benjlester/OpenHD-CM4-Carrier-Board/README.md

# OpenHD-CM4-Carrier-Board

This project is ongoing. Please see the [Open.HD wiki](https://openhd.gitbook.io/open-hd/) for more information. 

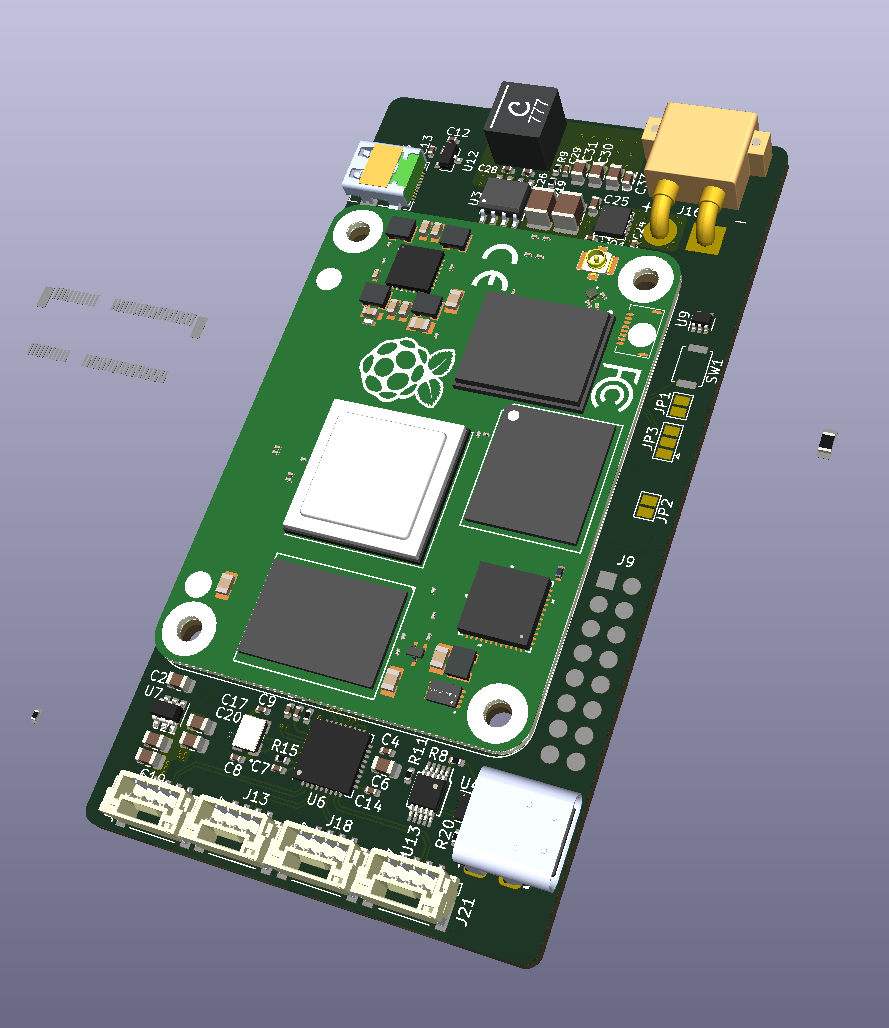
[picture p1: Docs/progress.PNG]
progresspic
