benjlester/OpenHD-CM4-Carrier-Board/Circuits/CM4_Carrier.pdf

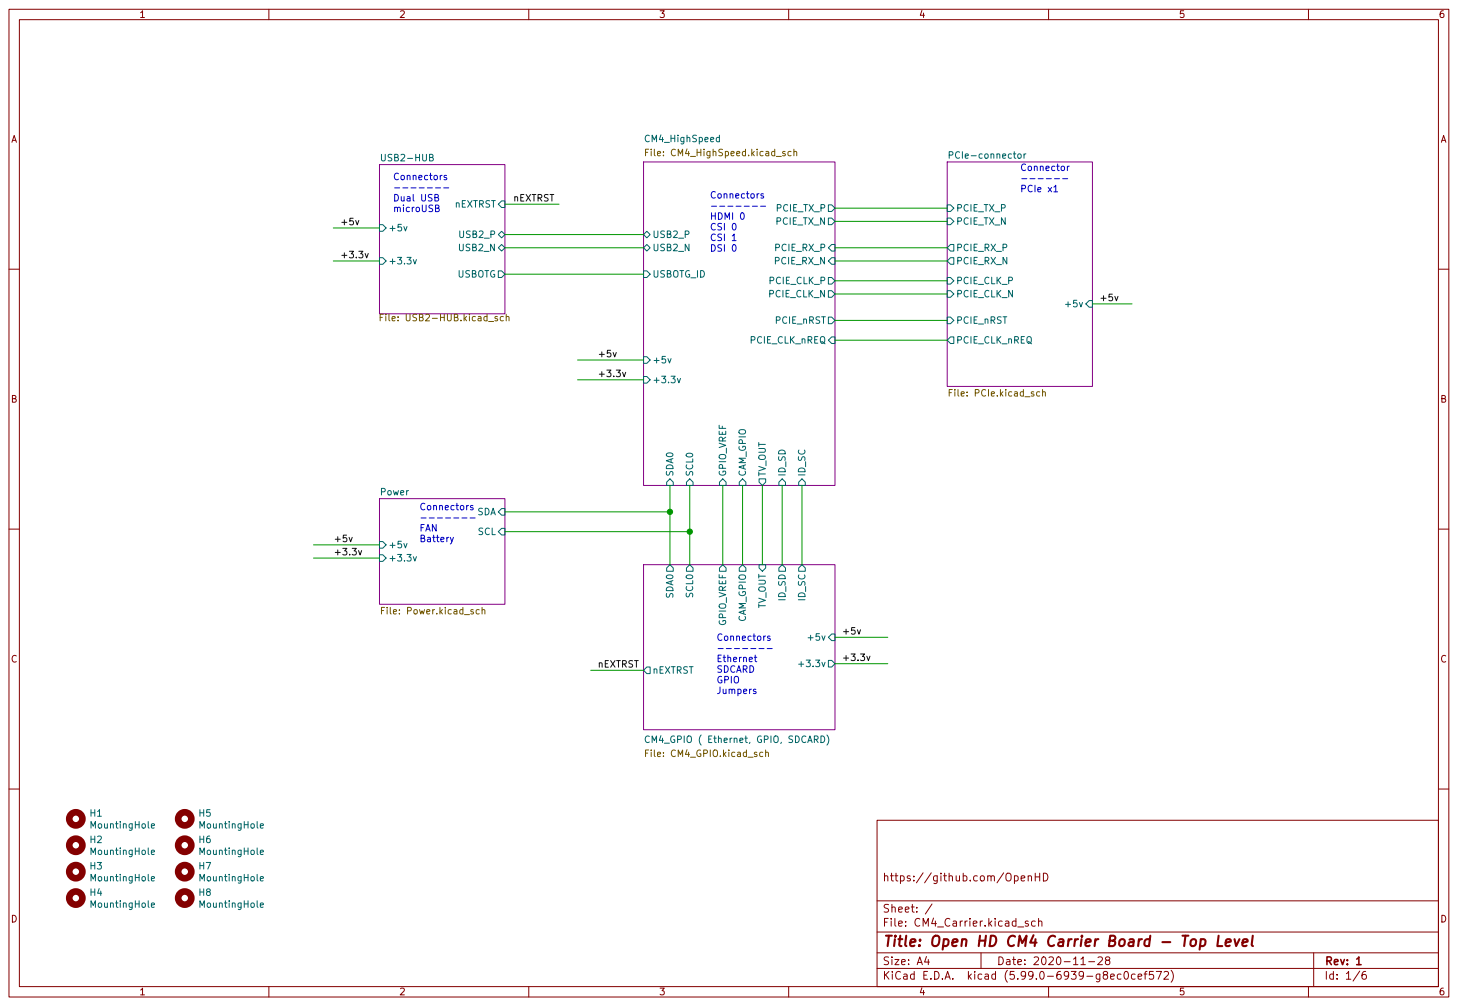
[picture p2: page 1]

------- Dual USB microUSB Connectors

PCIe-connector File: PCIe.kicad_sch PCIE_CLK_P

------ PCIe x1 Connectors
Connectors
------- HDMI 0 CSI 0 CSI 1 DSI 0

File: CM4_Carrier.kicad_sch Sheet: / https://github.com/OpenHD

Id: 1/6 Title: Open HD CM4 Carrier Board - Top Level

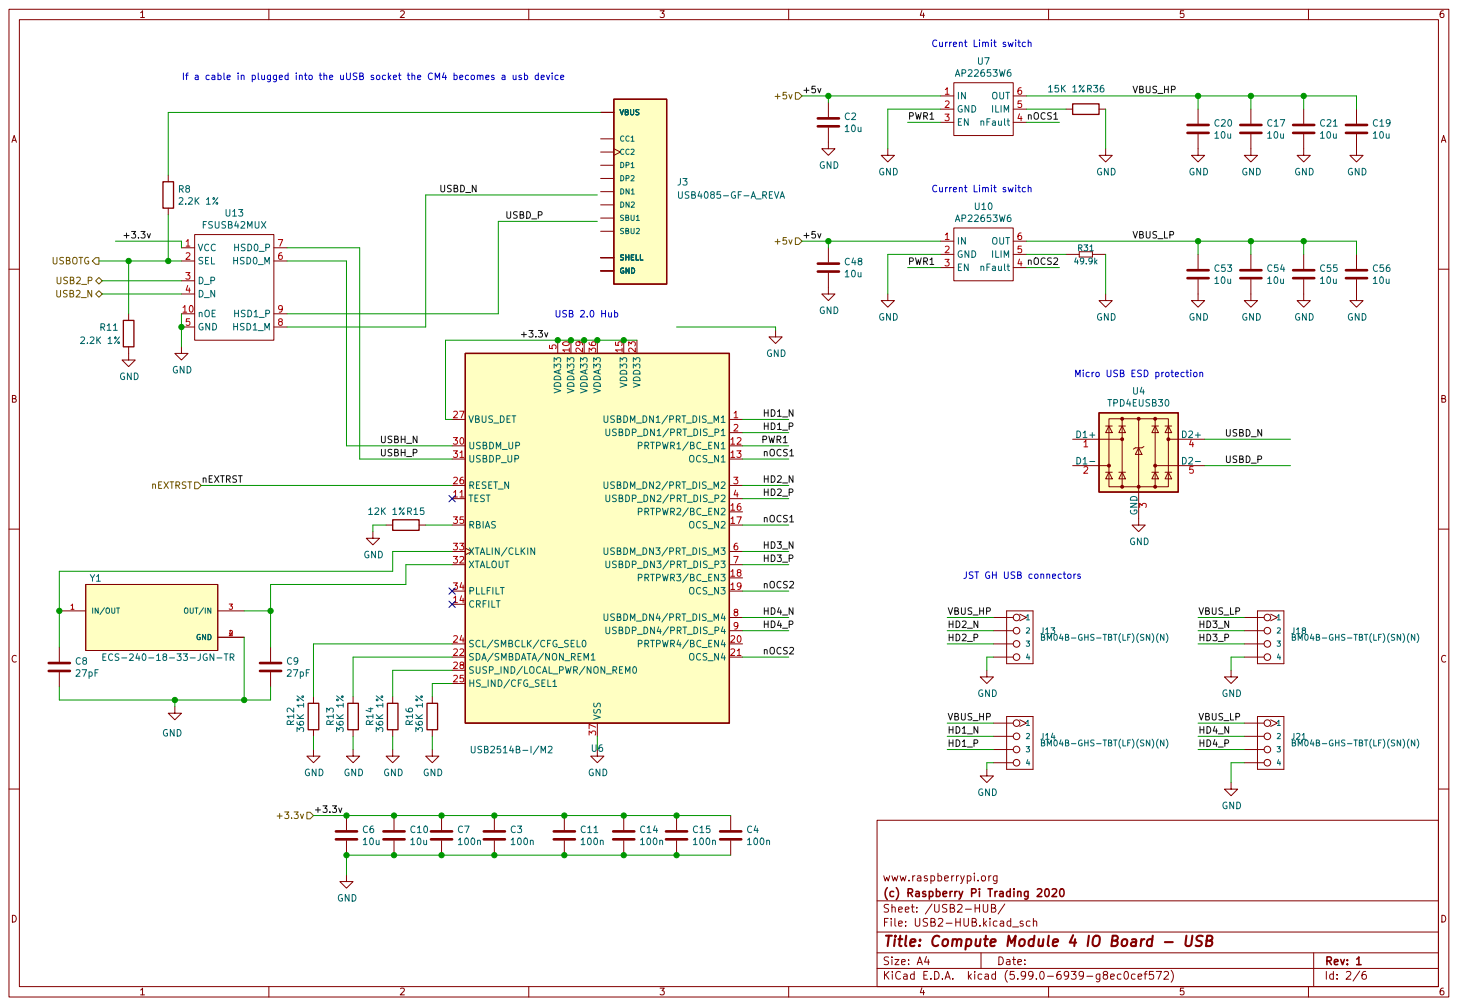
[picture p3: page 2]

JST GH USB connectors

www.raspberrypi.org
File: USB2-HUB.kicad_sch Sheet: /USB2-HUB/ (c) Raspberry Pi Trading 2020

Id: 2/6 Title: Compute Module 4 IO Board - USB

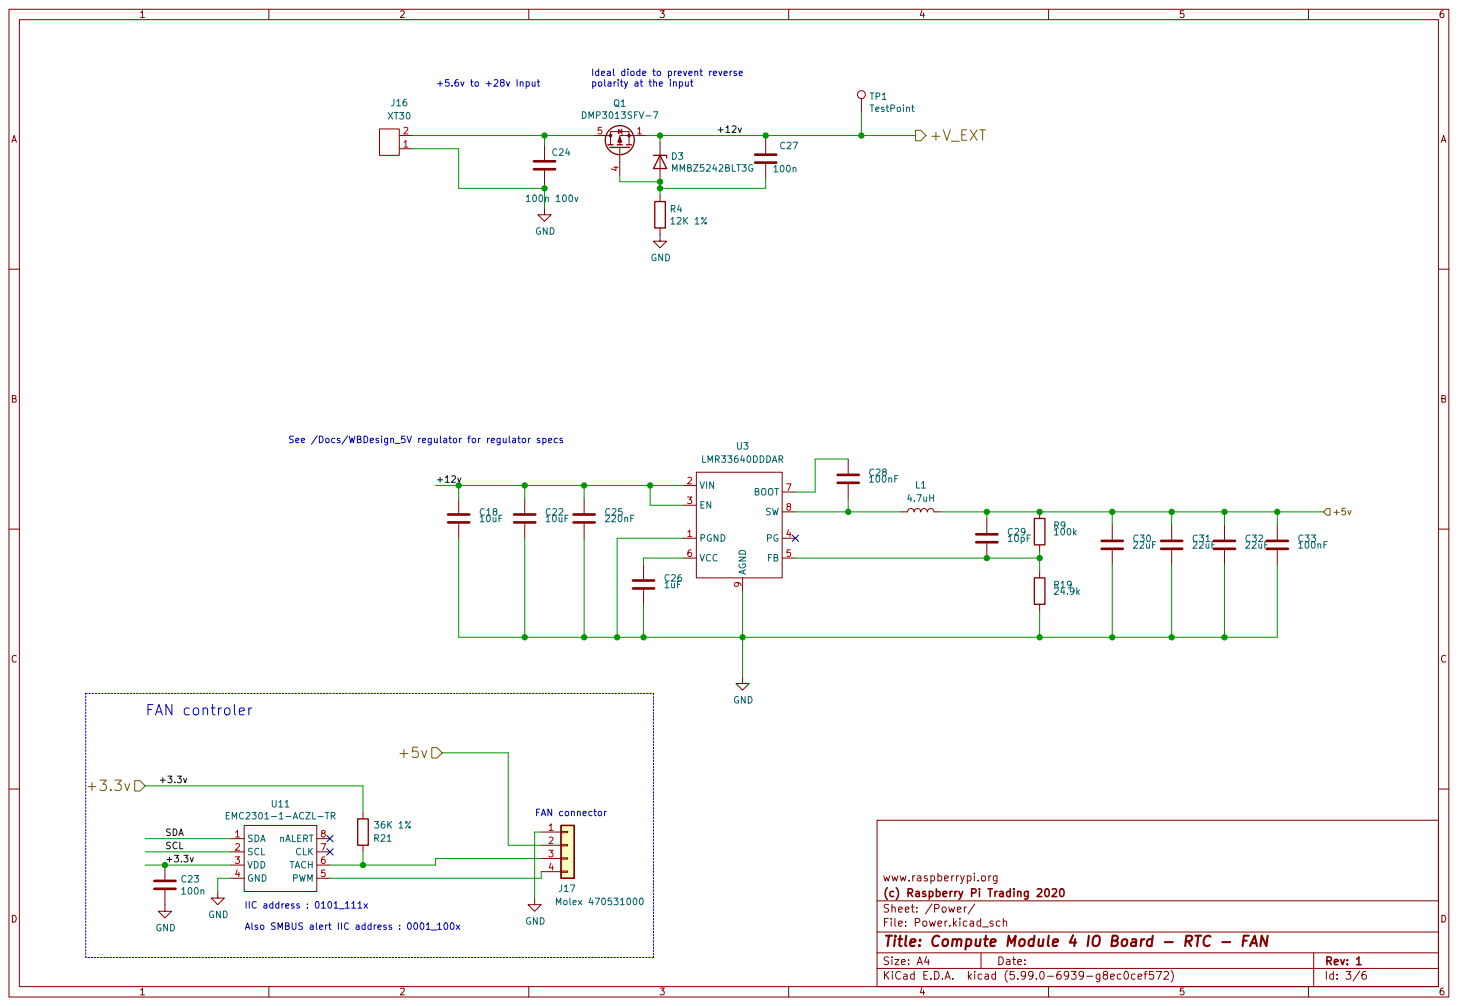
[picture p4: page 3]

Ideal diode to prevent reverse

www.raspberrypi.org GND

File: Power.kicad_sch Sheet: /Power/ (c) Raspberry Pi Trading 2020

IIC address : 0101_111x Also SMBUS alert IIC address : 0001_100x

Id: 3/6 Title: Compute Module 4 IO Board - RTC - FAN

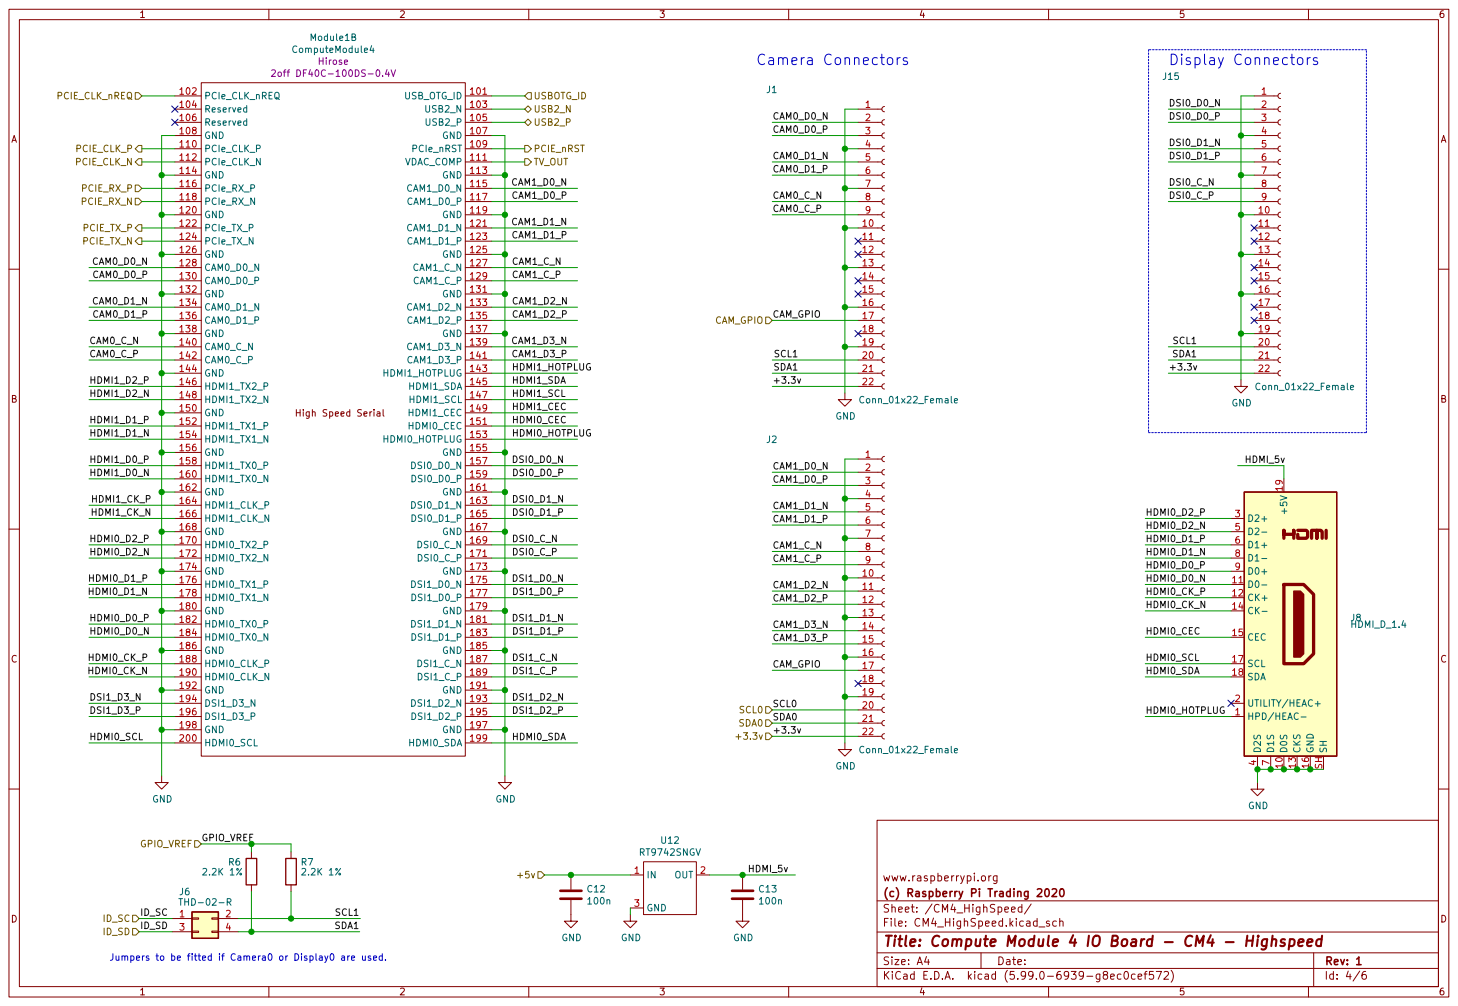
[picture p5: page 4]

(c) Raspberry Pi Trading 2020
Sheet: /CM4_HighSpeed/
File: CM4_HighSpeed.kicad_sch
Id: 4/6 Title: Compute Module 4 IO Board - CM4 - Highspeed

Jumpers to be fitted if Camera0 or Display0 are used.

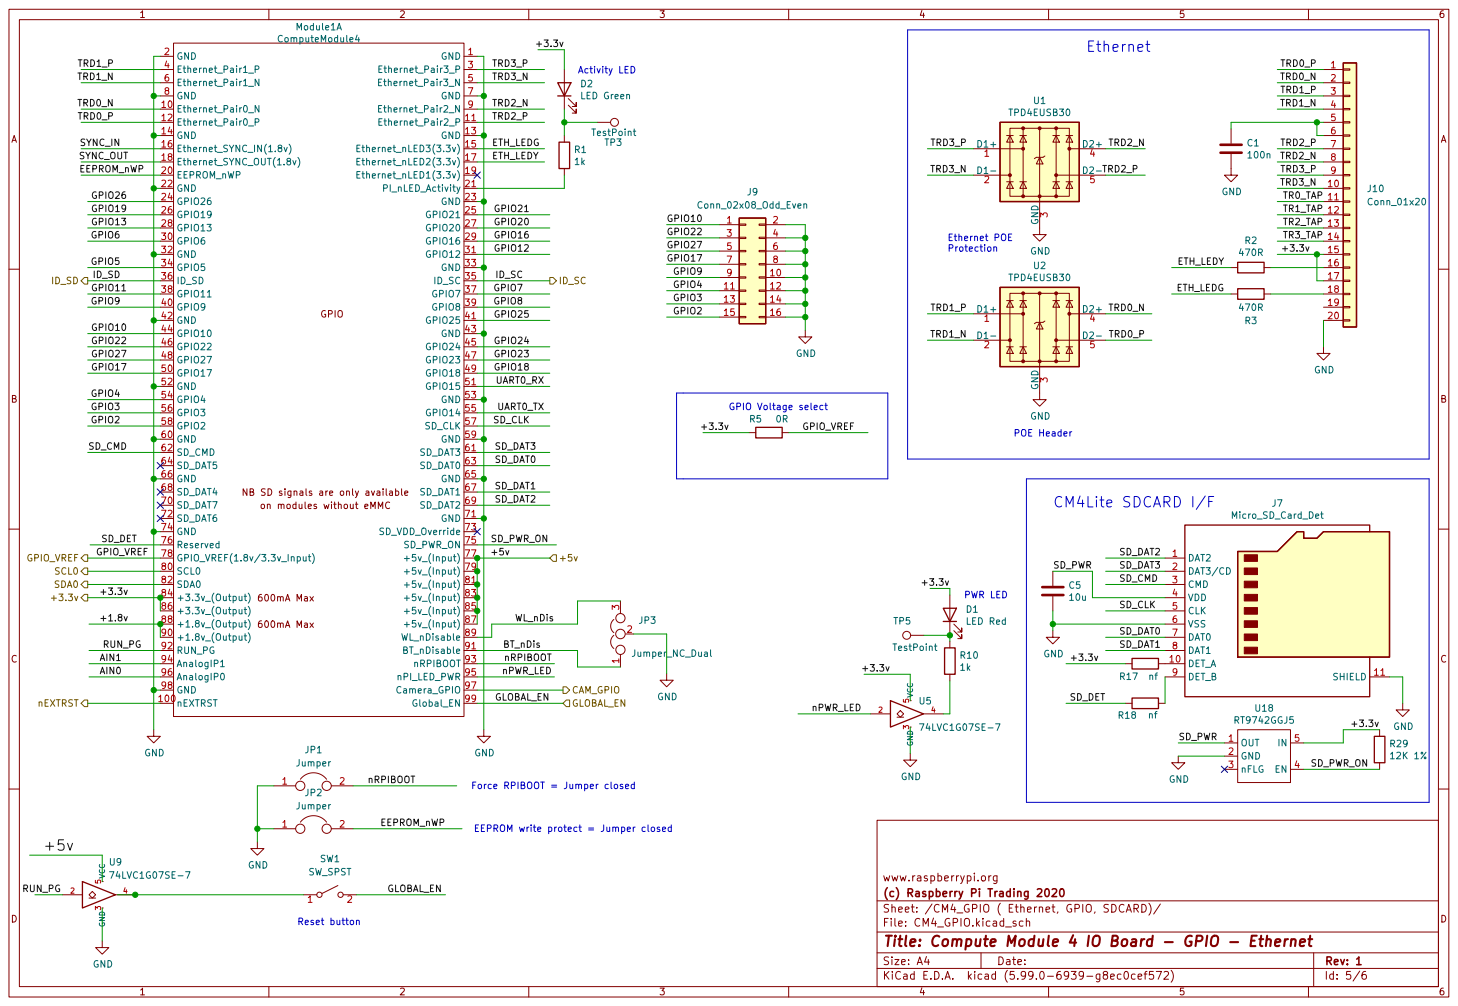
[picture p6: page 5]

600mA Max 600mA Max NB SD signals are only available

www.raspberrypi.org GND

Force RPIBOOT = Jumper closed

EEPROM write protect = Jumper closed

(c) Raspberry Pi Trading 2020
Sheet: /CM4_GPIO ( Ethernet, GPIO, SDCARD)/
File: CM4_GPIO.kicad_sch
Id: 5/6 Title: Compute Module 4 IO Board - GPIO - Ethernet

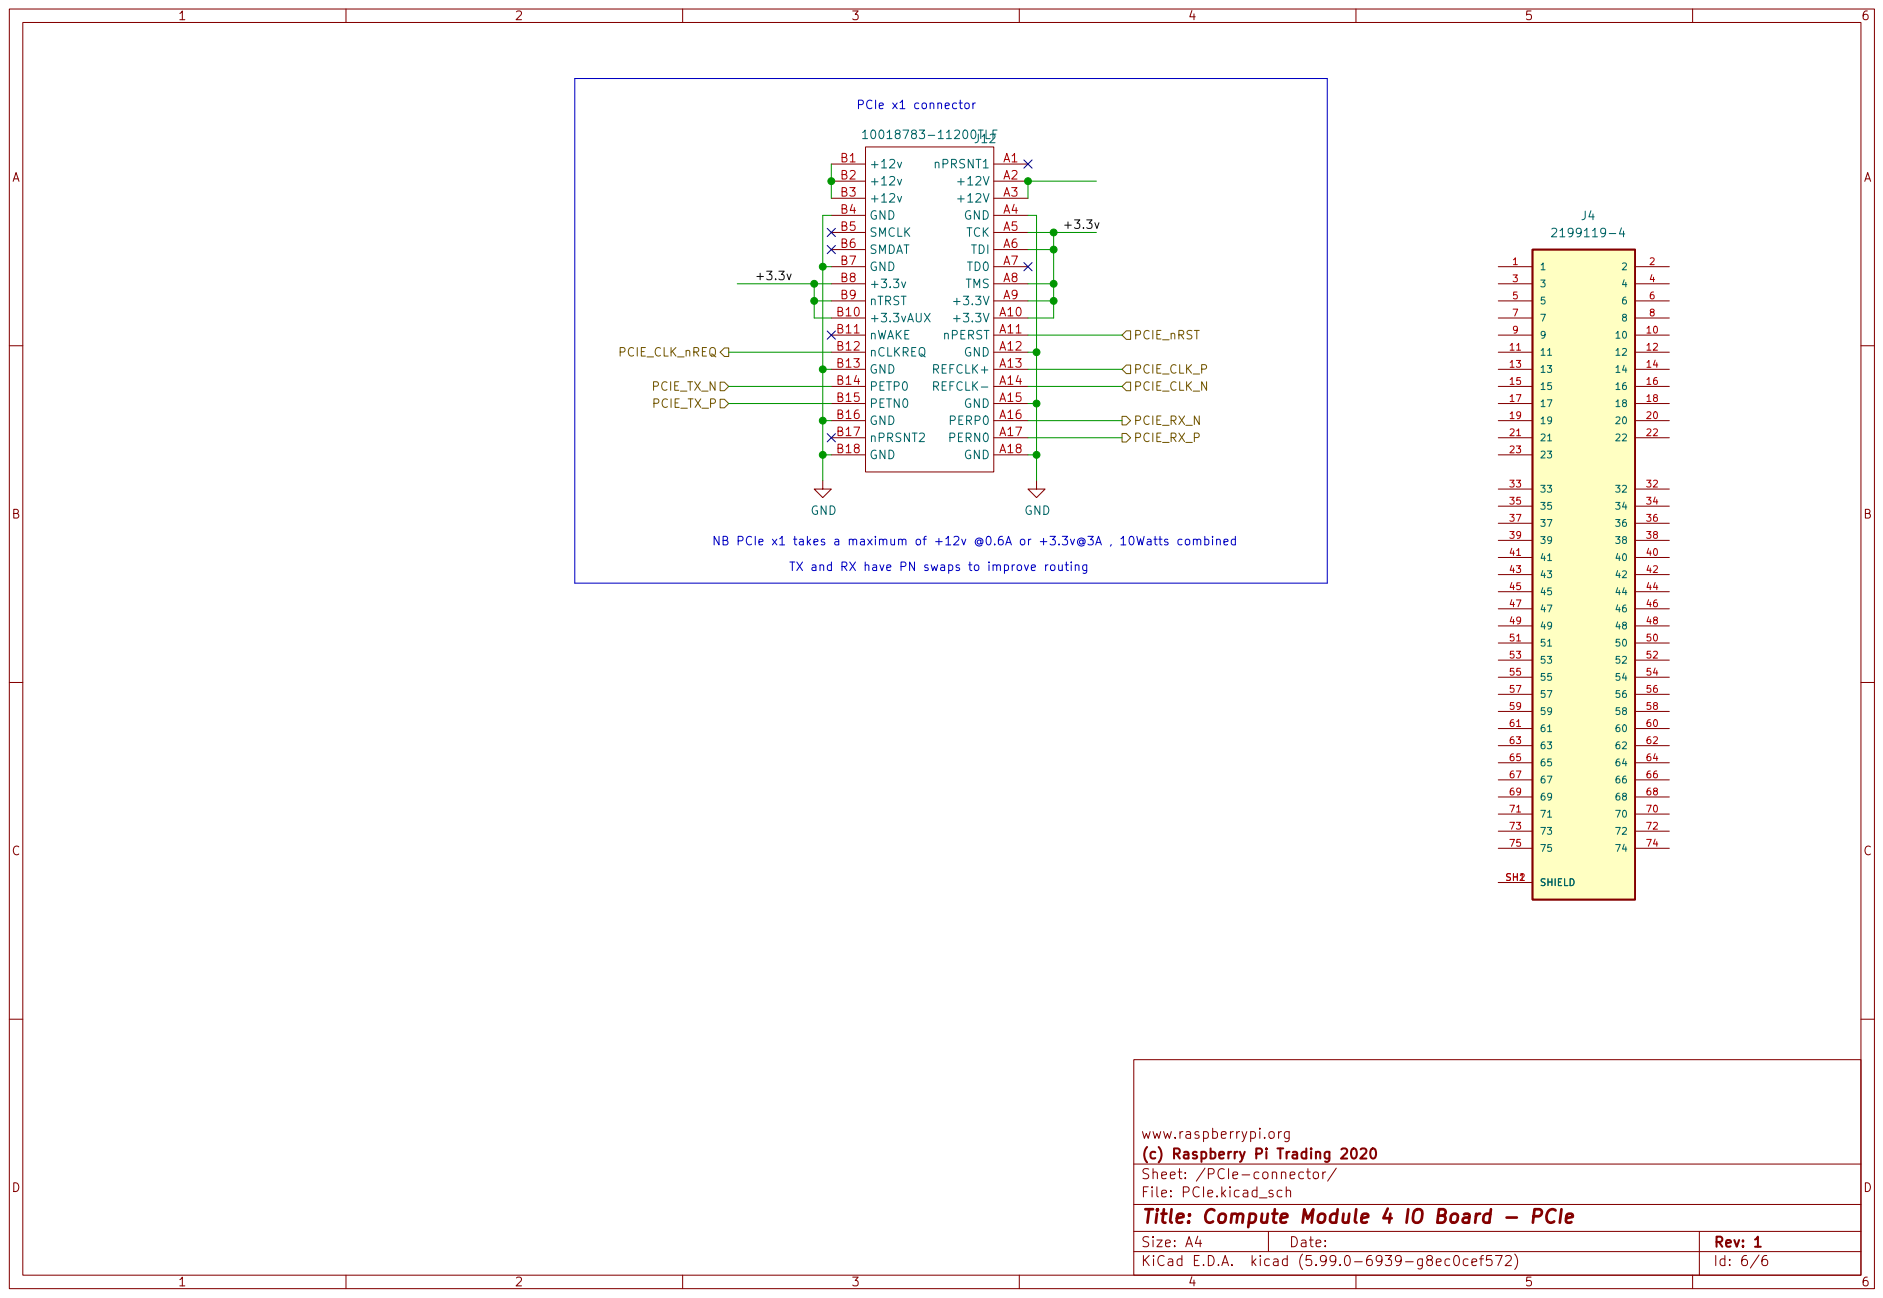
[picture p7: page 6]

TX and RX have PN swaps to improve routing PCIe x1 connector

www.raspberrypi.org
File: PCIe.kicad_sch Sheet: /PCIe-connector/ (c) Raspberry Pi Trading 2020

Id: 6/6 Title: Compute Module 4 IO Board - PCIe
