benjlester/OpenHD-CM4-Carrier-Board/(commit log)

2020-12-06 First commit, based on modified CM4IO board. Schematic changes started, broken layout ATM
    [CM4_Carrier.kicad_pcb, CM4_Carrier.kicad_sch, CM4_GPIO.kicad_sch, CM4_HighSpeed.kicad_sch, FAN.kicad_sch, PCIe.kicad_sch, PSUs.kicad_sch, USB2-HUB.kicad_sch]
2020-12-06 added original CM4IO pcb as starting point
    [CM4_Carrier.kicad_pcb]
2020-12-07 library management
    [CM4_Carrier.kicad_pcb, CM4_Carrier.kicad_sch, CM4_GPIO.kicad_sch, CM4_HighSpeed.kicad_sch, PCIe.kicad_sch, PSUs.kicad_sch, USB2-HUB.kicad_sch]
2020-12-09 added 3D models
    [CM4_Carrier.kicad_pcb, CM4_Carrier.kicad_sch, CM4_GPIO.kicad_sch, CM4_HighSpeed.kicad_sch, FAN.kicad_sch, PCIe.kicad_sch, PSUs.kicad_sch, USB2-HUB.kicad_sch]
2020-12-15 starting to lay out switching regulator
    [CM4_Carrier.kicad_pcb, CM4_Carrier.kicad_sch, CM4_GPIO.kicad_sch, CM4_HighSpeed.kicad_sch, FAN.kicad_sch, PCIe.kicad_sch, PSUs.kicad_sch, Power.kicad_sch]
2020-12-26 updating readme and some layout
    [CM4_Carrier.kicad_pcb, CM4_Carrier.kicad_sch, CM4_GPIO.kicad_sch, CM4_HighSpeed.kicad_sch, PCIe.kicad_sch, Power.kicad_sch, USB2-HUB.kicad_sch]
2021-02-14 started routing USB, added usb power switches, routing some USB-C
    [CM4_Carrier.kicad_pcb, CM4_Carrier.kicad_sch, CM4_GPIO.kicad_sch, CM4_HighSpeed.kicad_sch, PCIe.kicad_sch, Power.kicad_sch, USB2-HUB.kicad_sch]
2021-02-14 updated progress pictures
    [CM4_Carrier.kicad_pcb]
2021-02-23 lots of changes, added usb power connections, gpio, hdmi, etc
    [CM4_Carrier.kicad_pcb, CM4_Carrier.kicad_sch, CM4_GPIO.kicad_sch, CM4_HighSpeed.kicad_sch, PCIe.kicad_sch, Power.kicad_sch, USB2-HUB.kicad_sch]
2021-02-27 will probably have to rip up CSI connections, going to try lane swapping and reducing number of lanes
    [CM4_Carrier.kicad_pcb]
2021-02-27 ripped up csi connections
    [CM4_Carrier.kicad_pcb]
2021-03-15 Changed footprint to match CM4, removed Ethernet and HDMI
    [CM4_Carrier.kicad_pcb, CM4_Carrier.kicad_sch, CM4_GPIO.kicad_sch, CM4_HighSpeed.kicad_sch, Power.kicad_sch, USB2-HUB.kicad_sch]
2021-03-18 additional layout, power circuitry
    [CM4_Carrier.kicad_pcb, CM4_Carrier.kicad_sch, CM4_GPIO.kicad_sch, CM4_HighSpeed.kicad_sch, Power.kicad_sch, USB2-HUB.kicad_sch]
2021-05-23 May23 update
    [CM4_Carrier.kicad_pcb, CM4_Carrier.kicad_sch, CM4_GPIO.kicad_sch, CM4_HighSpeed.kicad_sch, Power.kicad_sch, USB2-HUB.kicad_sch]
